adafruit/Adafruit-APDS9960-Breakout-PCB/APDS-9960 Rev B.brd

## EAGLE design APDS-9960 Rev B.brd (2017-08-29)

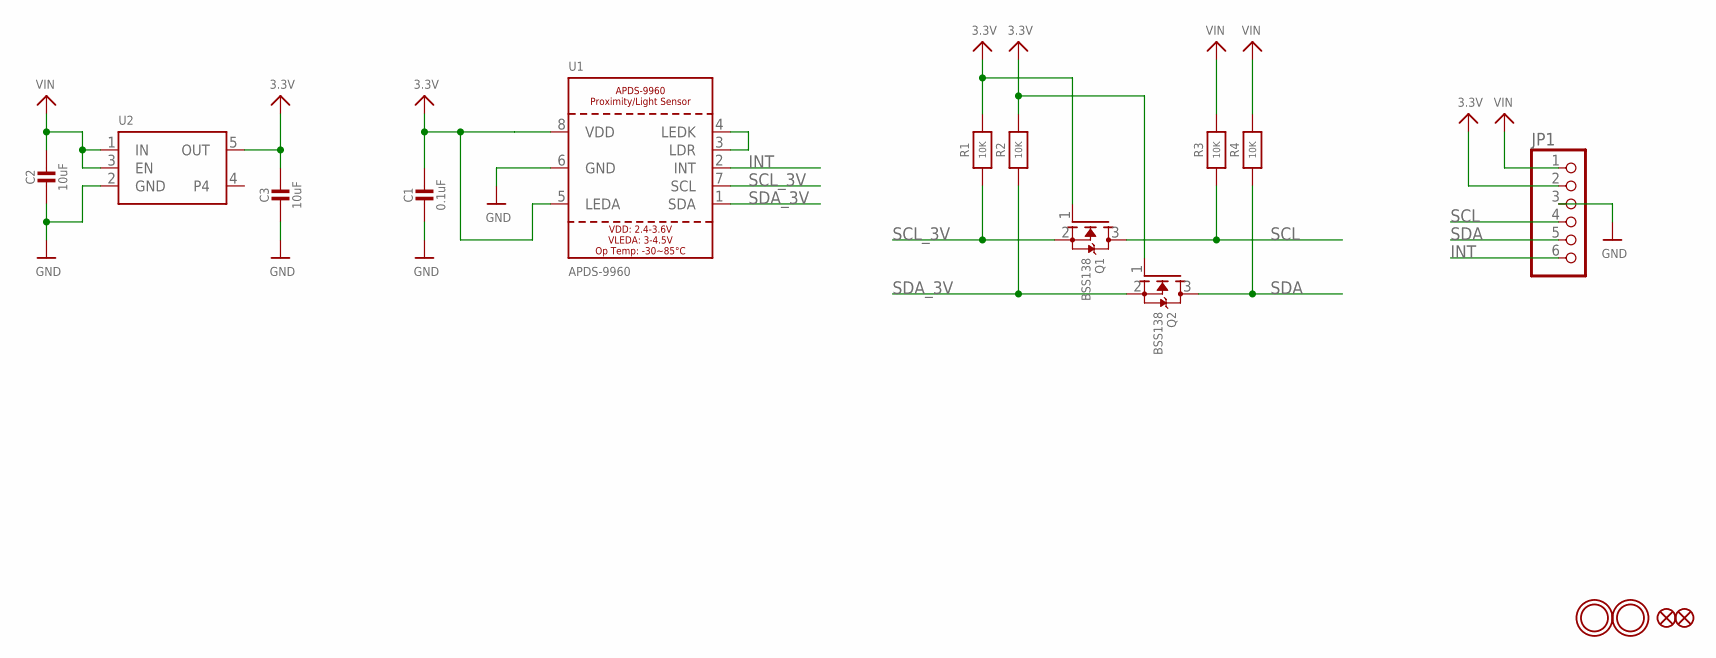
[picture p5: schematic APDS-9960 Rev B.sch]

Parts:
C1: 0.1uF; 0805-NO
C2, C3: 10uF; 0805-NO
FID1, FID2: FIDUCIAL_1MM
JP1: HEADER-1X676MIL; 1X06_ROUND_76
Q1, Q2: BSS138; SOT23-WIDE
R1, R2, R3, R4: 10K; 0805-NO
U1: APDS-9960
U2: VREG_SOT23-5; SOT23-5
U$1, U$2: MOUNTINGHOLE2.5; MOUNTINGHOLE_2.5_PLATED

Connections:
3.3V: C1.1, C3.1, JP1.2, Q1.1 (G), Q2.1 (G), R1.2, R2.2, U1.5 (LEDA), U1.8 (VDD), U2.5 (OUT)
GND: C1.2, C2.2, C3.2, JP1.3, U1.6 (GND), U2.2 (GND)
INT: JP1.6, U1.2 (INT)
unnamed: U1.3 (LDR), U1.4 (LEDK)
SCL: JP1.4, Q1.3 (D), R3.1
SCL_3V: Q1.2 (S), R1.1, U1.7 (SCL)
SDA: JP1.5, Q2.3 (D), R4.1
SDA_3V: Q2.2 (S), R2.1, U1.1 (SDA)
VIN: C2.1, JP1.1, R3.2, R4.2, U2.1 (IN), U2.3 (EN)

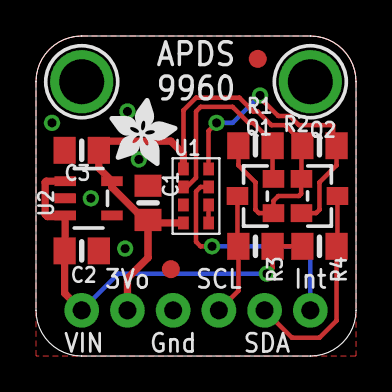
[picture p6: board APDS-9960 Rev B.brd from above]

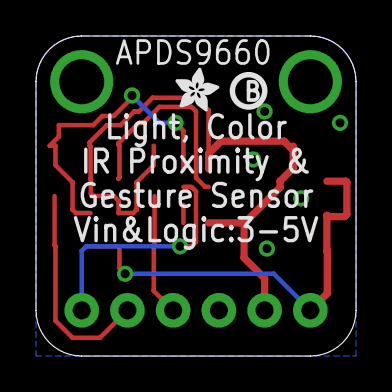
[picture p7: board APDS-9960 Rev B.brd from below]

Board: 2 copper layers, 17.8 x 17.8 mm, 19 parts (2 on the bottom side), 9 nets.

Other parts of the board:
U$17: PCBFEAT-REV-040
U$18: ADAFRUIT_2.5MM
U$19: ADAFRUIT_3.5MM
