adafruit/Adafruit-APDS9960-Breakout-PCB/(threads)

Thread 1 (2017-11-05):

Circuitpython

Tasm-Devil, 2017-11-05:
Hi there.

Is there a plan to make a circuitpython library for this amazing sensor?

Best regards,
Pascal

ladyada, 2017-11-05:
nope - we don't have it done yet! we'll make a new repo when we do :)

tannewt, 2017-11-06:
I made an issue in the adafruit/circuitpython repo to track this: https://github.com/adafruit/circuitpython/issues/411

Closed 2017-11-05.
